FishAres/plant_ephys/sim_results/01_scorecard.png

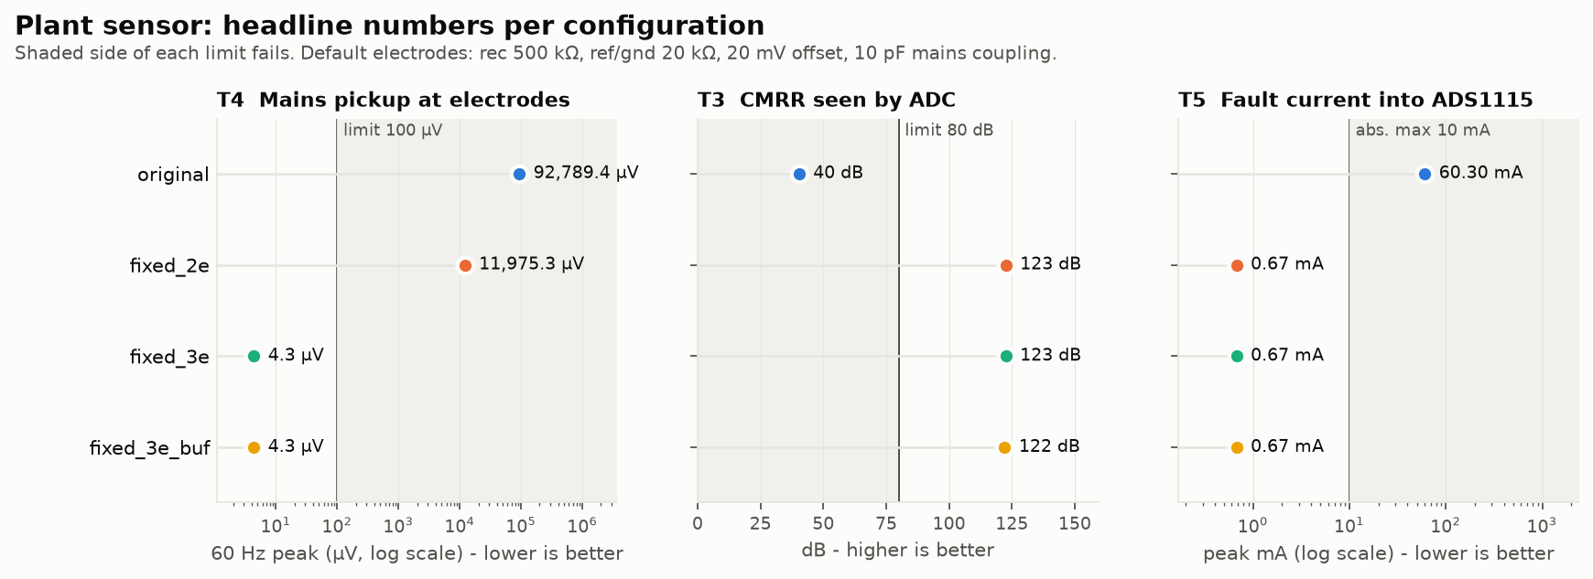
sim_results/01_scorecard.png
