FishAres/plant_ephys/sim_results/02_transfer_curve.png

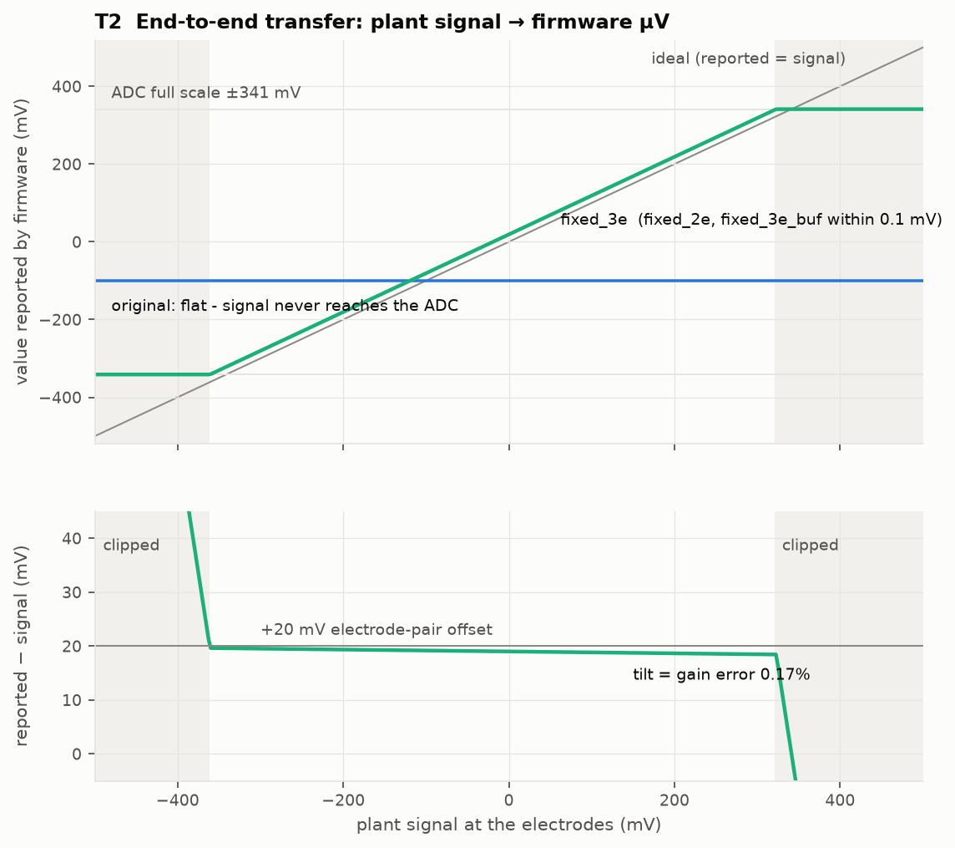
sim_results/02_transfer_curve.png
