FishAres/plant_ephys/sim_results/03_mains_pickup.png

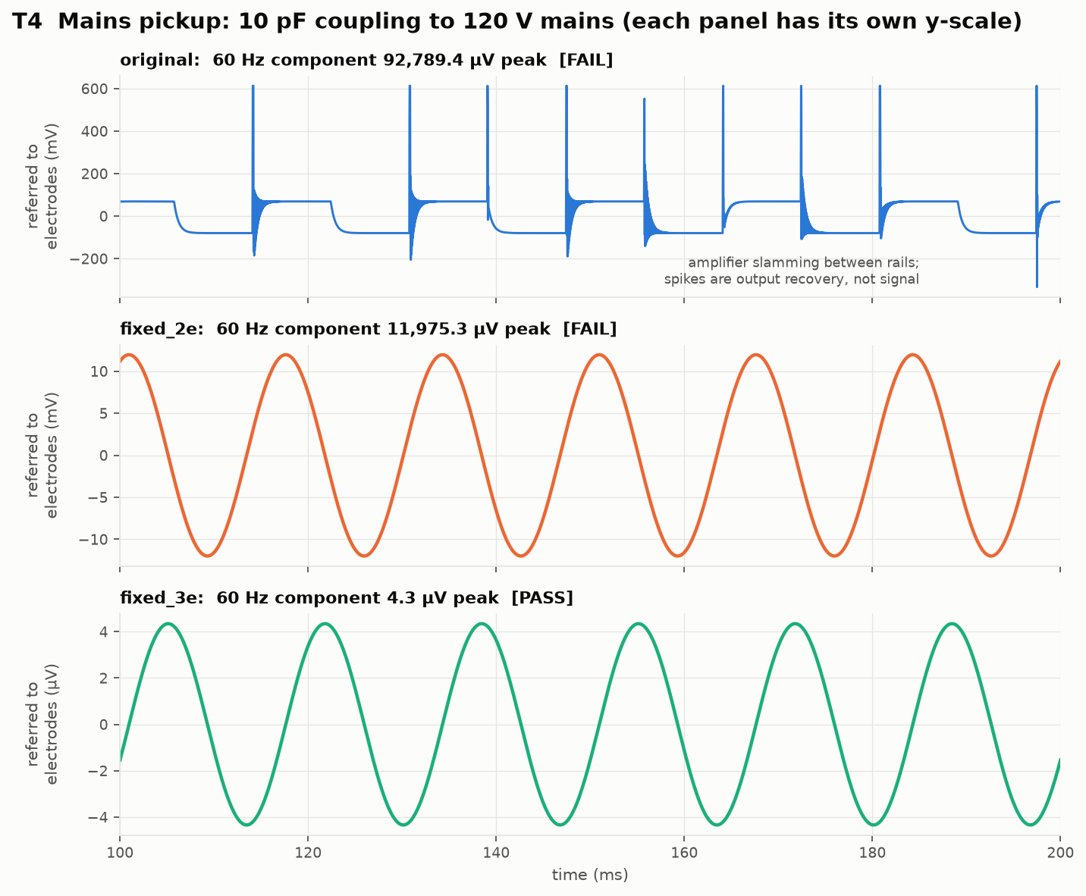
sim_results/03_mains_pickup.png
