FishAres/plant_ephys/sim_results/04_a1_matching.png

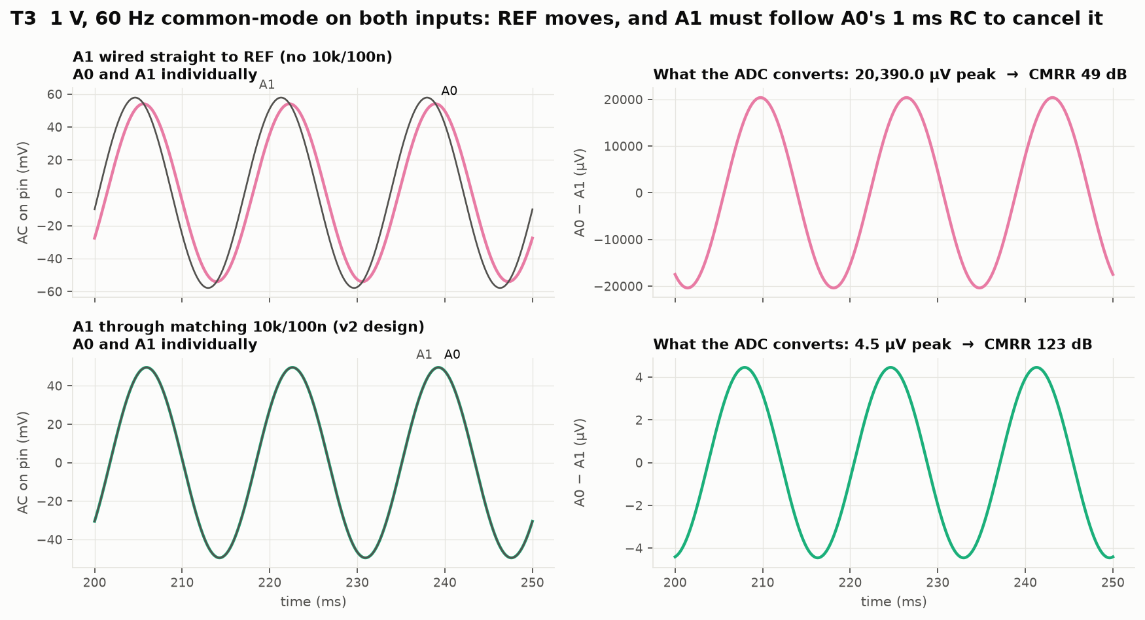
sim_results/04_a1_matching.png
