FishAres/plant_ephys/sim_results/05_fault_protection.png

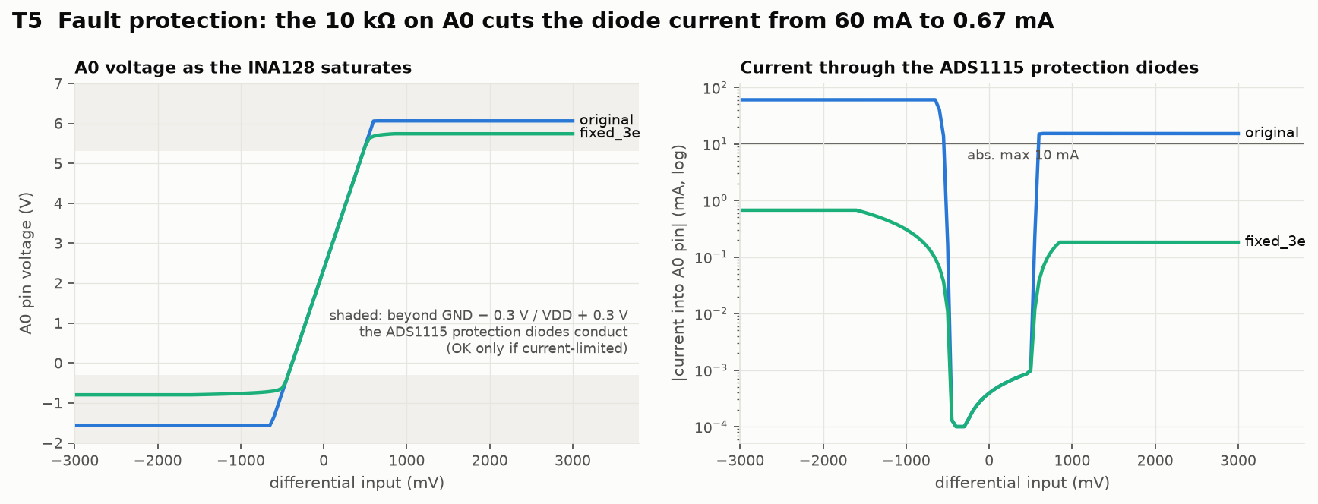
sim_results/05_fault_protection.png
