FishAres/plant_ephys/sim_results/06_stress_sweep.png

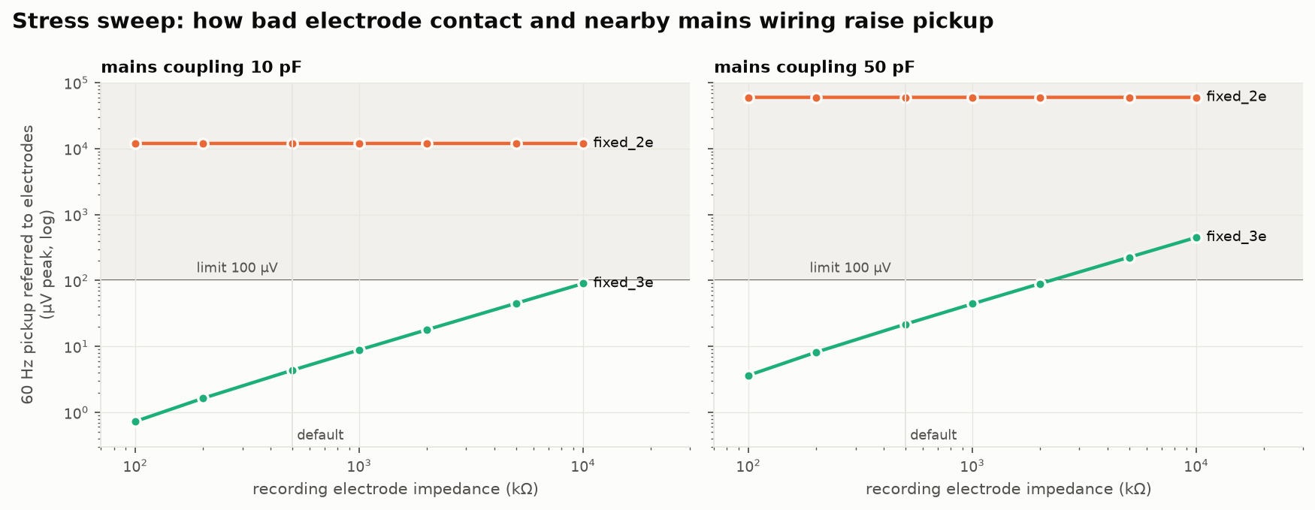
sim_results/06_stress_sweep.png
