FishAres/plant_ephys/sim_results/mains_pickup.png

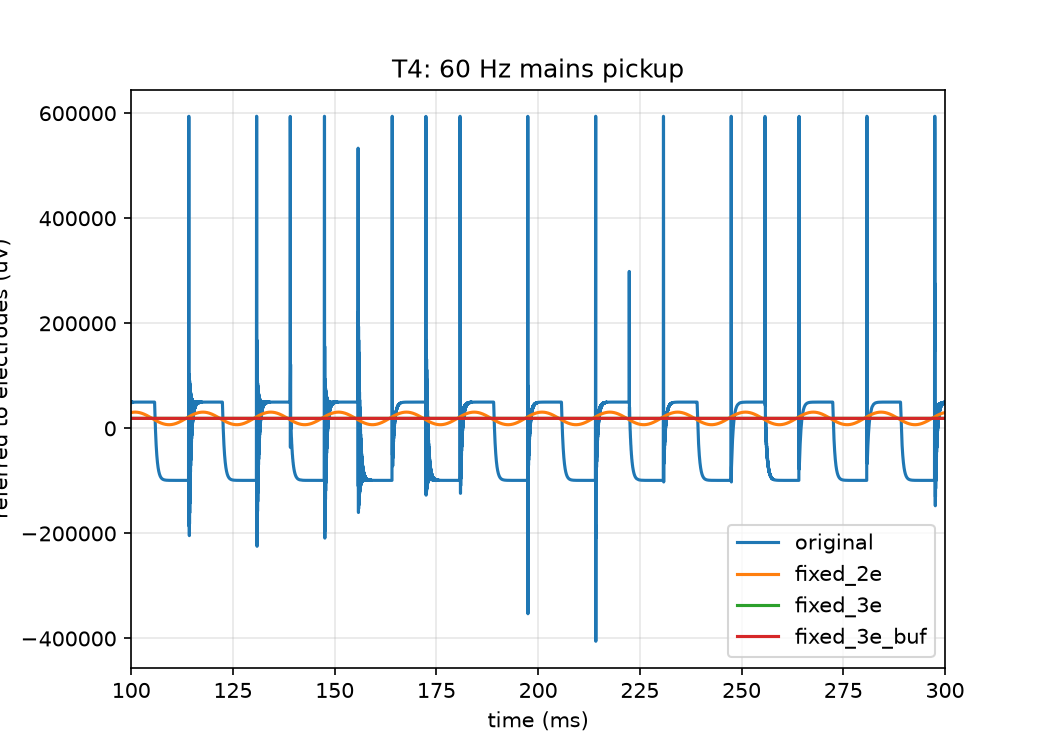
sim_results/mains_pickup.png
