FishAres/plant_ephys/sim_results/transfer_curve.png

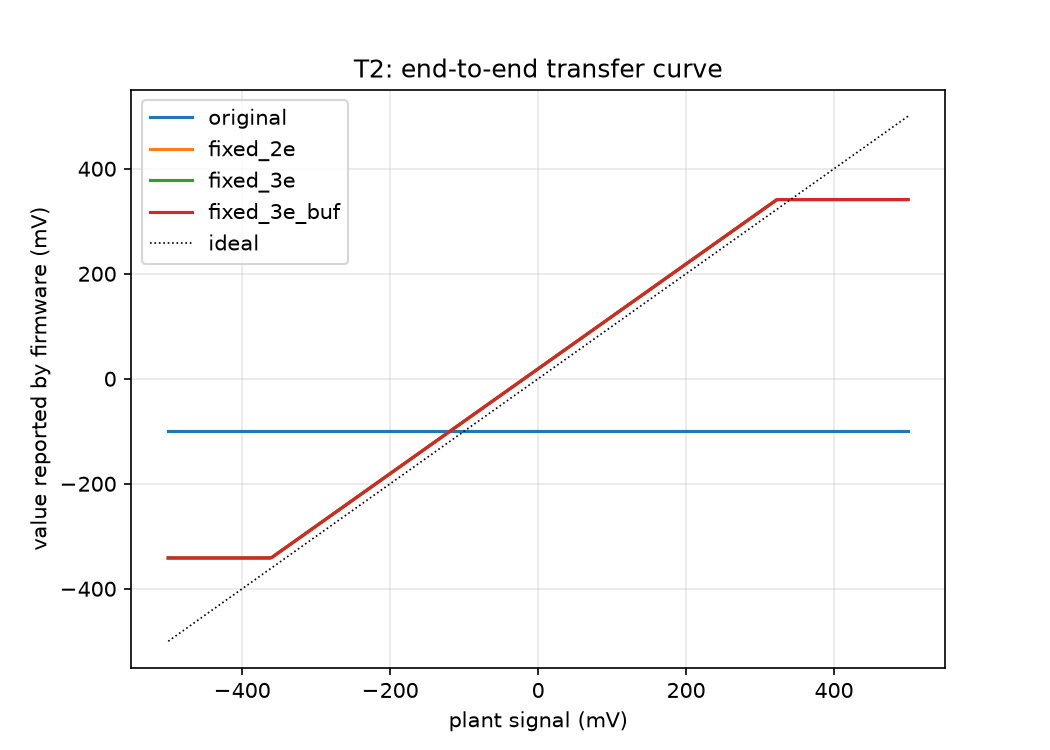
sim_results/transfer_curve.png
